SVeneziani/LogiVOX/Foto_Video/IMG_3594.jpeg

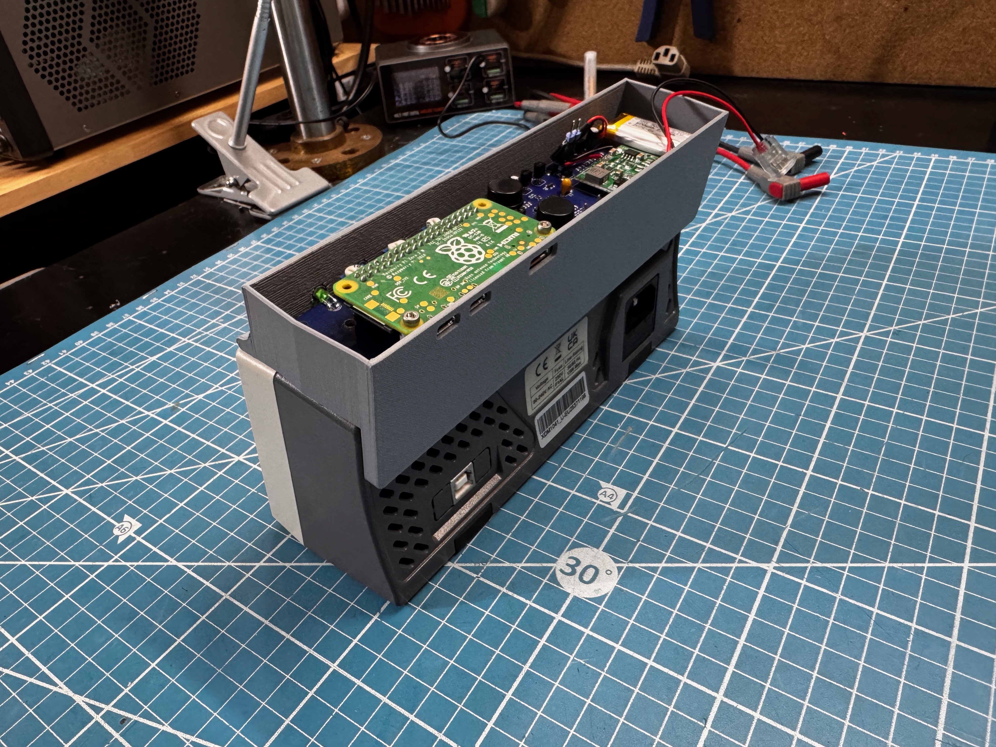
Foto_Video/IMG_3594.jpeg
