SVeneziani/LogiVOX/Foto_Video/IMG_3406.jpeg

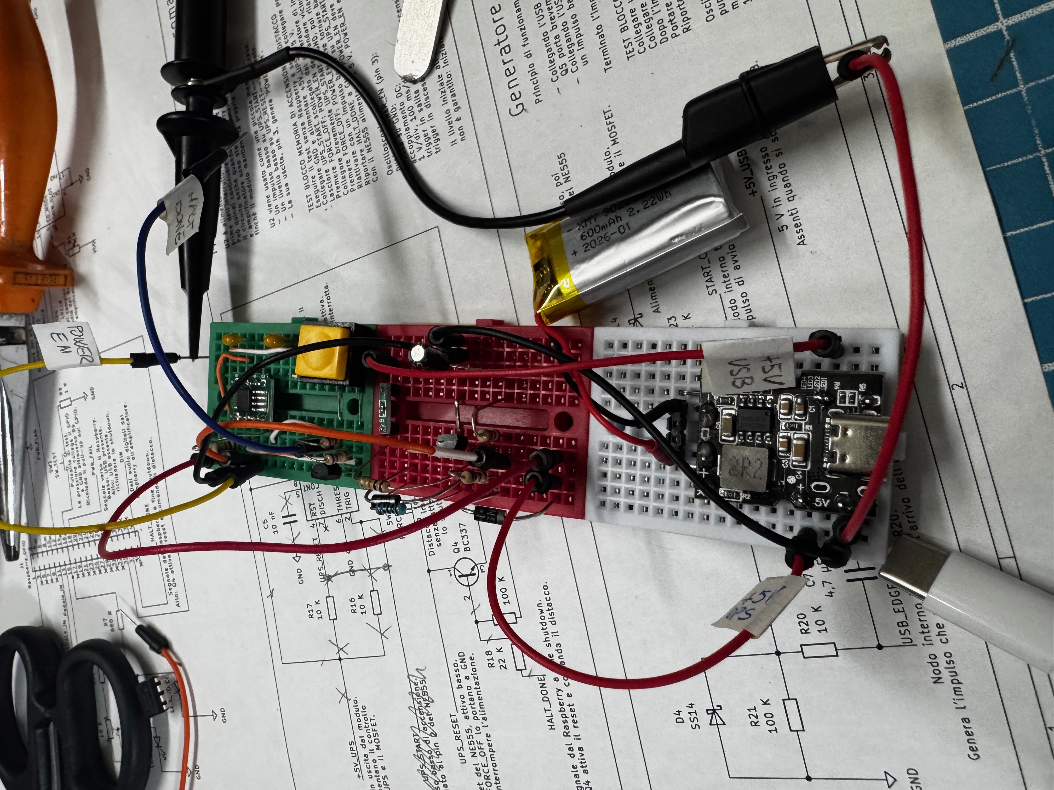
Foto_Video/IMG_3406.jpeg
