SVeneziani/LogiVOX/README.md

# LogiVOX

**Eyes on the probes. Ears on the measurement.**

[▶ Project video — 1 min 35 s, Full HD](Foto_Video/LogiVOX-presentation.mp4)

LogiVOX is a DIY speaking companion for the **OWON XDM1041**, built by Sergio Veneziani using a Raspberry Pi Zero 2 W, USB communication, a MAX98357A I²S amplifier, a foot pedal and a custom enclosure.

Keep your hands on the probes and let your multimeter speak. Tap a foot pedal for a reading, or enable AUTO to hear stable, meaningful changes. LogiVOX adds a voice to the bench through USB, without opening the multimeter.

[Documentazione italiana](README.it.md) · [Hardware review](docs/HARDWARE-REVIEW.md) · [TALK/AUTO](docs/TALK-AUTO.md)

## Project status

The assembled prototype works and has been tested by its builder. This repository is a **public development snapshot**, not yet a reproducible fabrication release. PCB DRC and schematic/PCB parity checks are clean; print instructions and neutral CAD exports are pending, as are audio redistribution and software licensing.

## Features

- Press the foot pedal or briefly press TALK to hear a reading.
- Hold TALK for two seconds to toggle AUTO, with spoken confirmation.
- AUTO speaks stable, significant changes instead of repeating every few seconds.
- Italian prerecorded number/unit fragments: normal operation does not require a cloud TTS service.
- READY and VOICE indicators.
- Battery-backed orderly shutdown, followed by hardware power disconnection.
- An existing OWON server supplies the USB connection, web dashboard and measurement API.

Only the OWON XDM1041 has been tested with this build. AUTO defaults to off at startup. FORCE OFF cuts power directly; it is not an orderly software shutdown.

## Parts used in the prototype

See the [component links](docs/COMPONENTS.md) for the foot pedal, power module and panel connectors used by the builder.

## Repository layout

- `Software/raspberry/bin/`: voice playback, pedal/TALK/AUTO and UPS services.
- `Software/raspberry/tests/`: hardware-independent logic tests.
- `Software/raspberry/services/`: existing service templates (paths currently reference the prototype user).
- `Software/tools/`: local voice generation helper for macOS.
- `hardware/kicad/`: current schematic/PCB/project snapshot.
- `docs/`: current pinout, operating notes and outstanding hardware review.
- `3D/`: Autodesk Fusion design and Bambu Studio project.
- `enclosure/`: enclosure file inventory and remaining print documentation.
- [Foto_Video/](Foto_Video/): 16 original photographs, the project presentation and a demonstration video.

## Tests

```sh
python3 -m unittest discover -s Software/raspberry/tests -v
```

The optional audio-file presence test is skipped when the voice pack is absent. This does not validate audio playback or the physical UPS.

## Installation status

See [installation notes](docs/INSTALLATION.md). The prototype runs Debian 13 on a Raspberry Pi Zero 2 W. A clean-device installation guide and complete service packaging are still being prepared; do not treat the current files as a one-click installer.

## Credits

- Design, assembly, mechanical enclosure and bench testing: **Sergio Veneziani**.
- Development and troubleshooting assistance: OpenAI ChatGPT/Codex; additional debugging with Cursor.
- USB/web/API backend: [Jason Antman's owon-xdm1041-server](https://github.com/jantman/owon-xdm1041-server), licensed MIT by its author. The backend is a separate dependency and is not vendored here.
- SCPI research credited by that backend: [TheHWcave/OWON-XDM1041](https://github.com/TheHWcave/OWON-XDM1041).
- Initial inspiration: [Arduino-Based Speech Add-on for Modern Multimeters with SCPI Protocol](https://www.pcbway.com/project/shareproject/Arduino_Based_Speech_Add_on_for_Modern_Multimeters_with_SCPI_Protocol_95abefd4.html). The original Arduino sketch is not included in this repository.

## Licensing

Original hardware and enclosure design contributions are offered under **CC BY-NC-SA 4.0**: attribution, noncommercial use and ShareAlike for shared adaptations. Commercial permission and any royalties require a separate written agreement with Sergio Veneziani.

See [licensing scope and exceptions](LICENSE.md). Software, general documentation, photographs/video, third-party materials and voice recordings are not covered by this design-file license. Earlier valid license grants are not revoked.
