SVeneziani/LogiVOX/docs/HARDWARE-REVIEW.md

# Hardware review before fabrication

Updated 2026-11-04 from the saved builder files. Design files were copied unchanged. The prototype was manually reworked; this snapshot is not yet a fabrication release. No old Gerbers are included.

## Verified PCB check

KiCad CLI DRC with schematic parity enabled reports:

- **0 DRC violations**.
- **0 unconnected items**.
- **0 schematic/PCB parity issues**.

Previous findings are no longer reported under the saved project rules. This verifies design-rule compliance and schematic/PCB consistency, not independent circuit operation or compatibility with a manufacturer's process. Check fabrication limits and generate fresh manufacturing outputs before ordering.
