SVeneziani/LogiVOX/Foto_Video/README.md

# LogiVOX — Foto e video

Materiali forniti da Sergio Veneziani: costruzione e prototipo. Le fotografie e il filmato IMG_3606.mov sono conservati senza modifiche.

## Presentazione

[▶ LogiVOX — video di presentazione](LogiVOX-presentation.mp4)

Durata circa 95 secondi, 1920×1080. Copia MP4 H.264/AAC compressa per la pubblicazione, derivata dal montaggio fornito dall’autore l’8 novembre 2026. Il montaggio non è stato modificato; l’originale resta conservato localmente.

## Foto e prima dimostrazione

- [IMG_3399.jpeg](IMG_3399.jpeg)
- [IMG_3405.jpeg](IMG_3405.jpeg)
- [IMG_3406.jpeg](IMG_3406.jpeg)
- [IMG_3407.jpeg](IMG_3407.jpeg)
- [IMG_3574.jpeg](IMG_3574.jpeg)
- [IMG_3575.jpeg](IMG_3575.jpeg)
- [IMG_3576.jpeg](IMG_3576.jpeg)
- [IMG_3578.jpeg](IMG_3578.jpeg)
- [IMG_3579.jpeg](IMG_3579.jpeg)
- [IMG_3580.jpeg](IMG_3580.jpeg)
- [IMG_3581.jpeg](IMG_3581.jpeg)
- [IMG_3582.jpeg](IMG_3582.jpeg)
- [IMG_3593.jpeg](IMG_3593.jpeg)
- [IMG_3594.jpeg](IMG_3594.jpeg)
- [IMG_3605.jpeg](IMG_3605.jpeg)
- [IMG_3606.mov](IMG_3606.mov)
- [IMG_3607.jpeg](IMG_3607.jpeg)
