SVeneziani/LogiVOX/Foto_Video/IMG_3399.jpeg

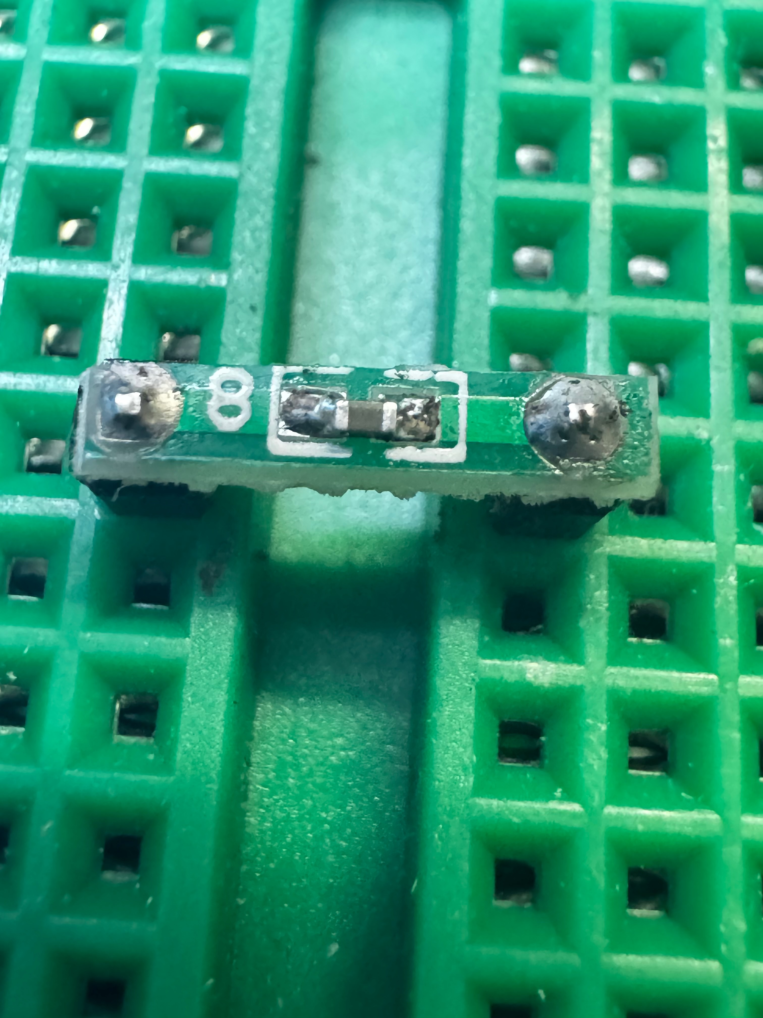
Foto_Video/IMG_3399.jpeg
