SVeneziani/LogiVOX/Foto_Video/IMG_3405.jpeg

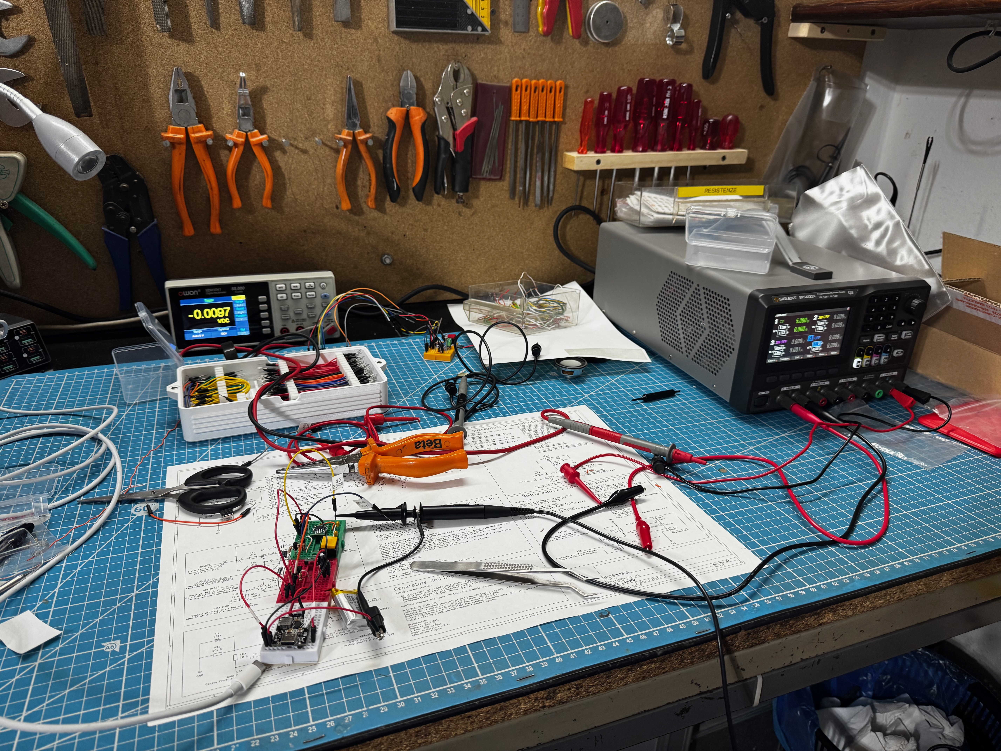
Foto_Video/IMG_3405.jpeg
