SVeneziani/LogiVOX/Foto_Video/IMG_3407.jpeg

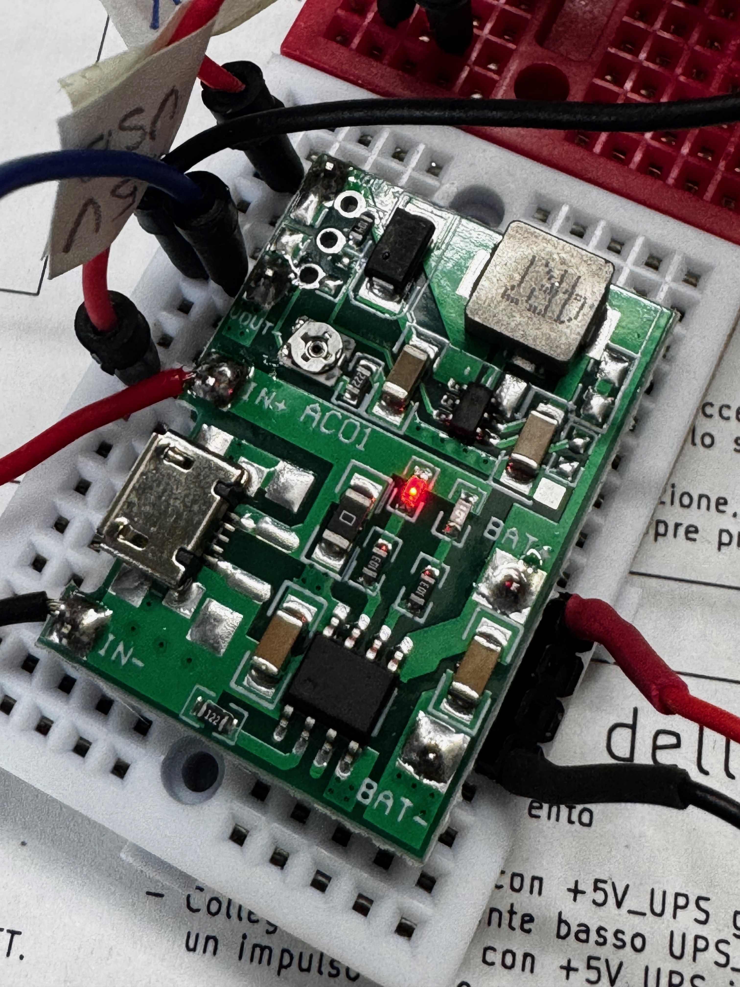
Foto_Video/IMG_3407.jpeg
