SVeneziani/LogiVOX/Foto_Video/IMG_3574.jpeg

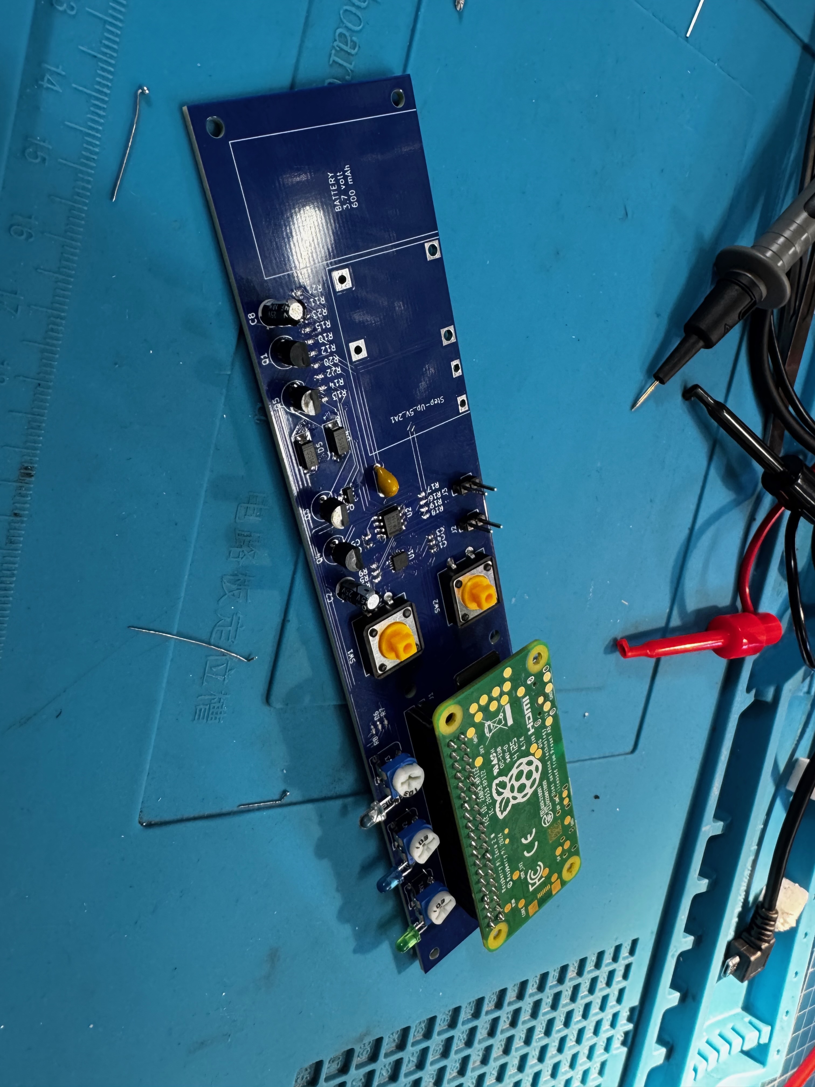
Foto_Video/IMG_3574.jpeg
