SVeneziani/LogiVOX/Foto_Video/IMG_3575.jpeg

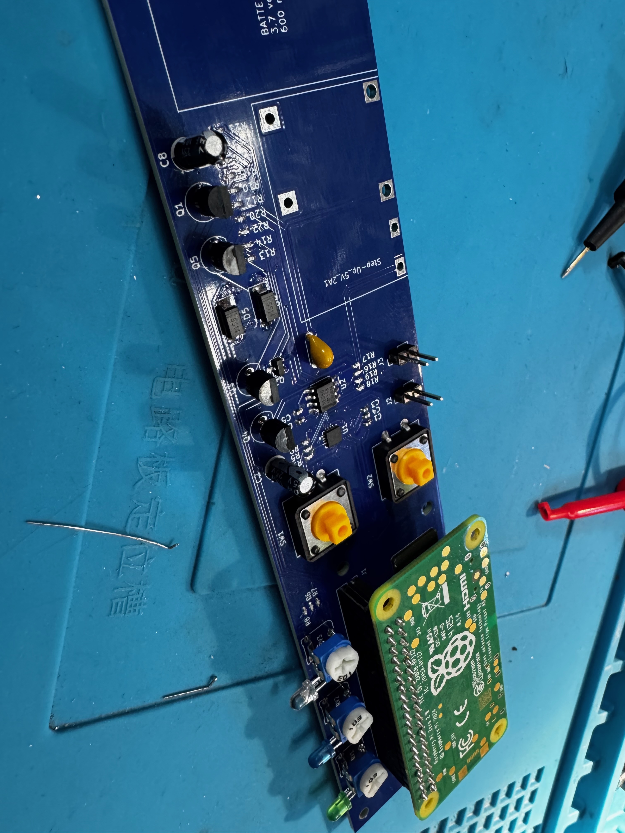
Foto_Video/IMG_3575.jpeg
