SVeneziani/LogiVOX/Foto_Video/IMG_3576.jpeg

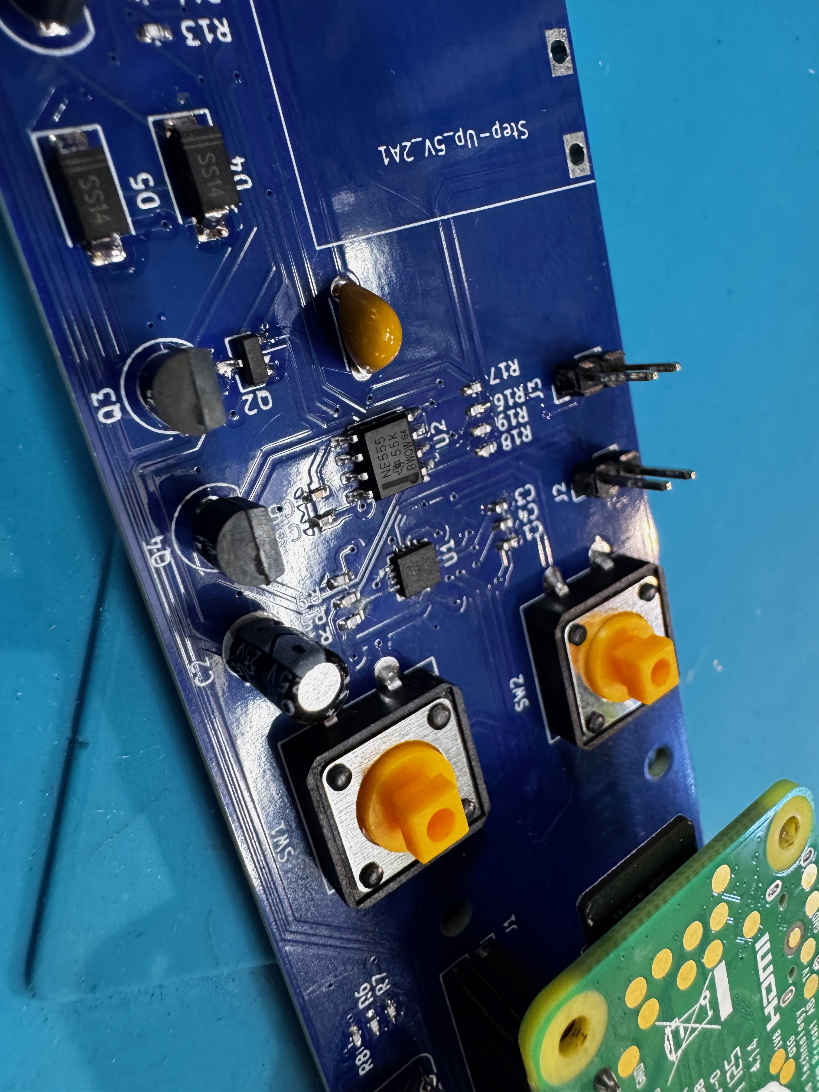
Foto_Video/IMG_3576.jpeg
