SVeneziani/LogiVOX/Foto_Video/IMG_3578.jpeg

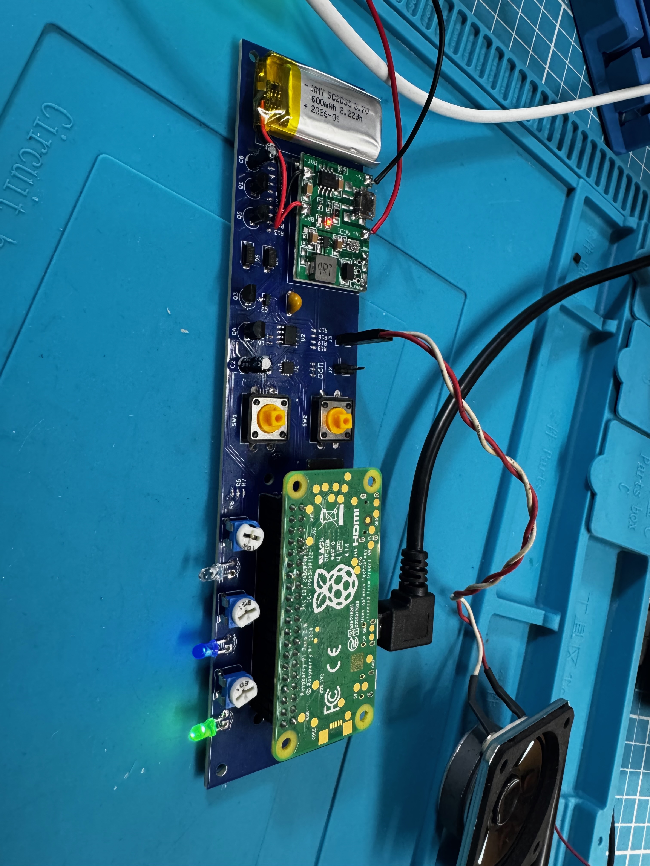
Foto_Video/IMG_3578.jpeg
