SVeneziani/LogiVOX/Foto_Video/IMG_3579.jpeg

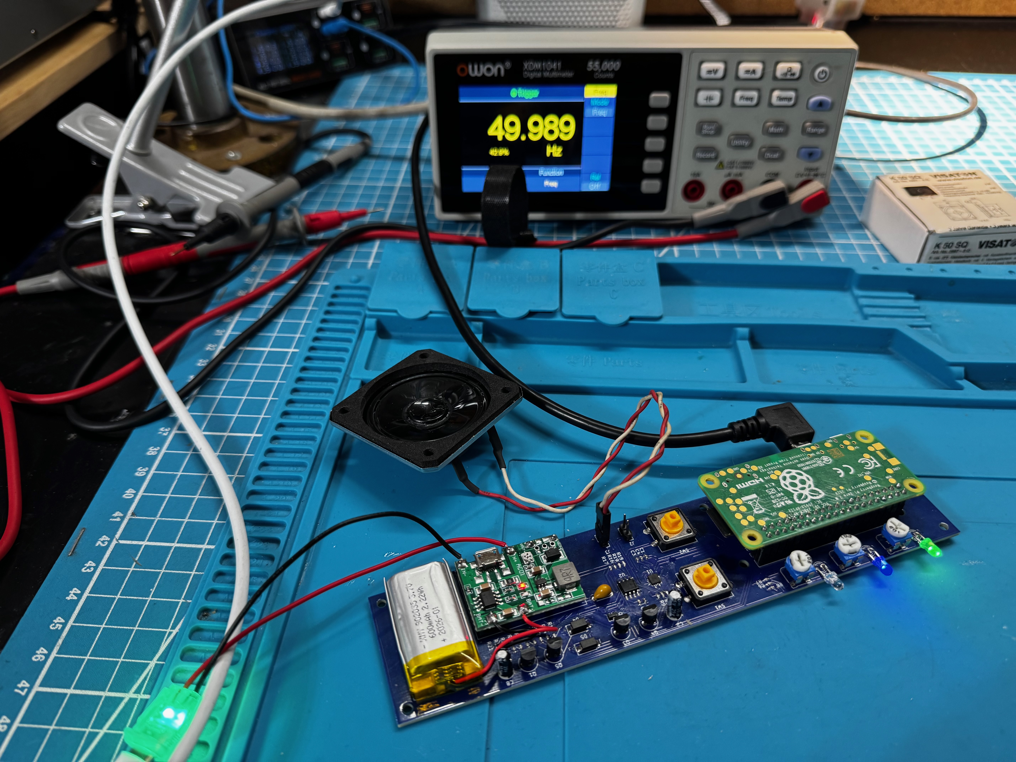
Foto_Video/IMG_3579.jpeg
