SVeneziani/LogiVOX/Foto_Video/IMG_3580.jpeg

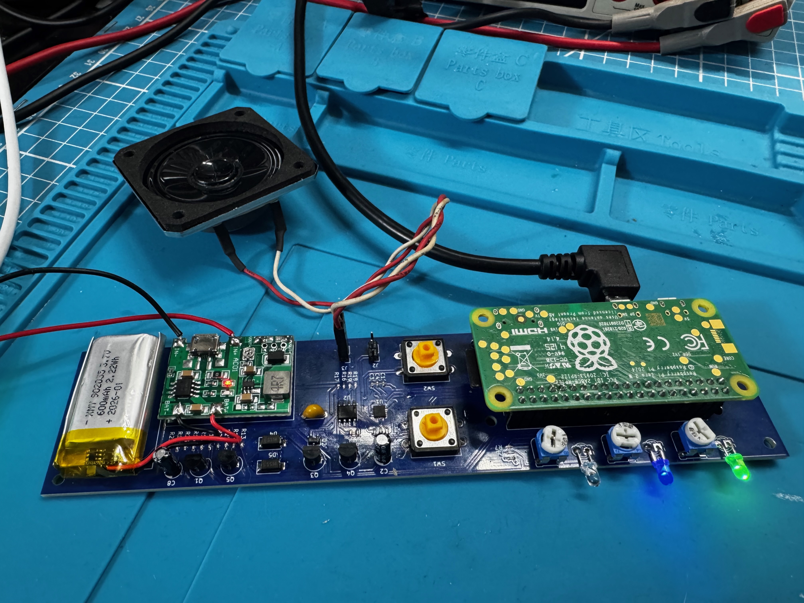
Foto_Video/IMG_3580.jpeg
