SVeneziani/LogiVOX/Foto_Video/IMG_3581.jpeg

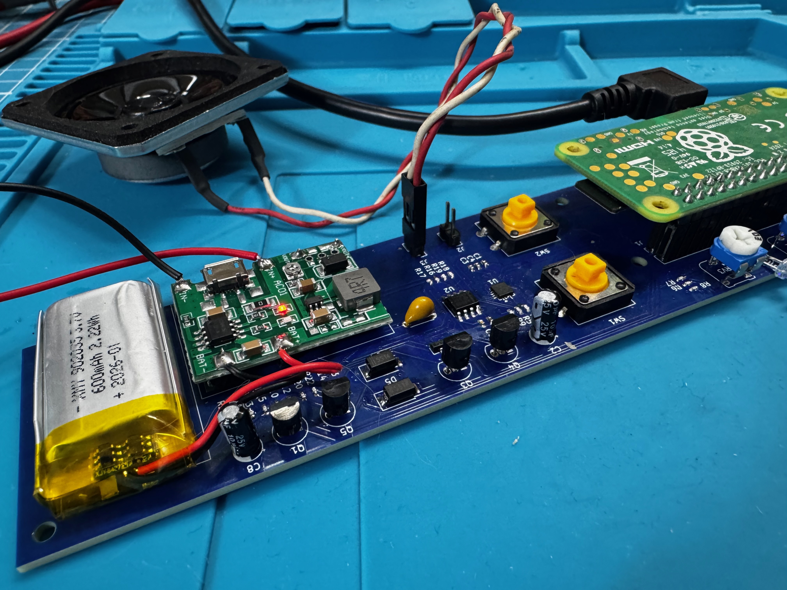
Foto_Video/IMG_3581.jpeg
