SVeneziani/LogiVOX/Foto_Video/IMG_3582.jpeg

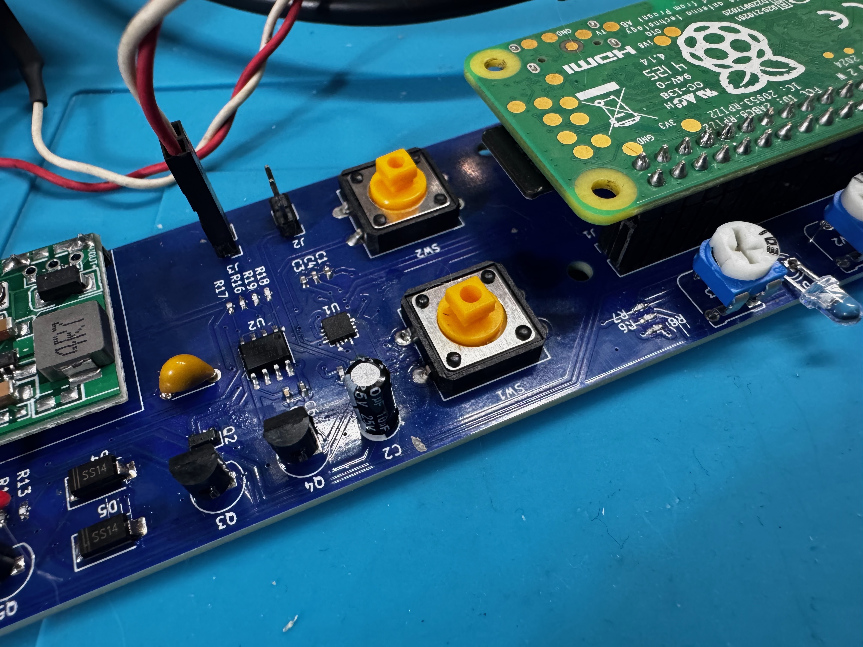
Foto_Video/IMG_3582.jpeg
