SVeneziani/LogiVOX/Foto_Video/IMG_3593.jpeg

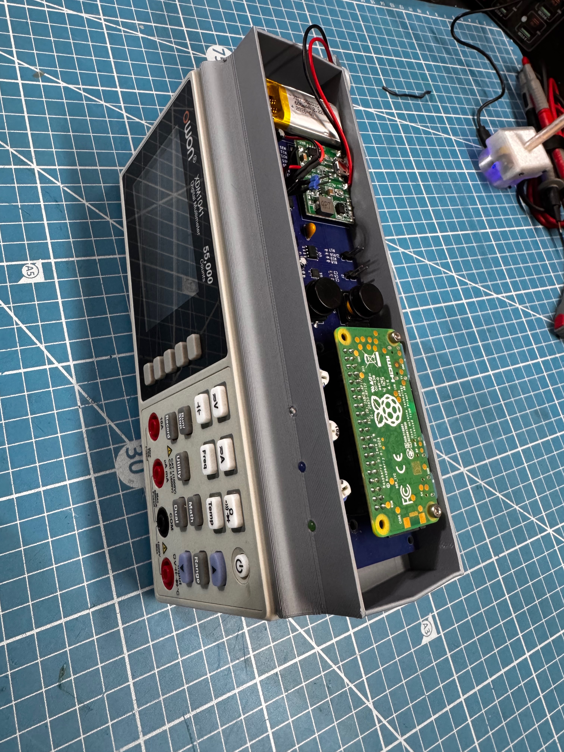
Foto_Video/IMG_3593.jpeg
