SVeneziani/LogiVOX/Foto_Video/IMG_3605.jpeg

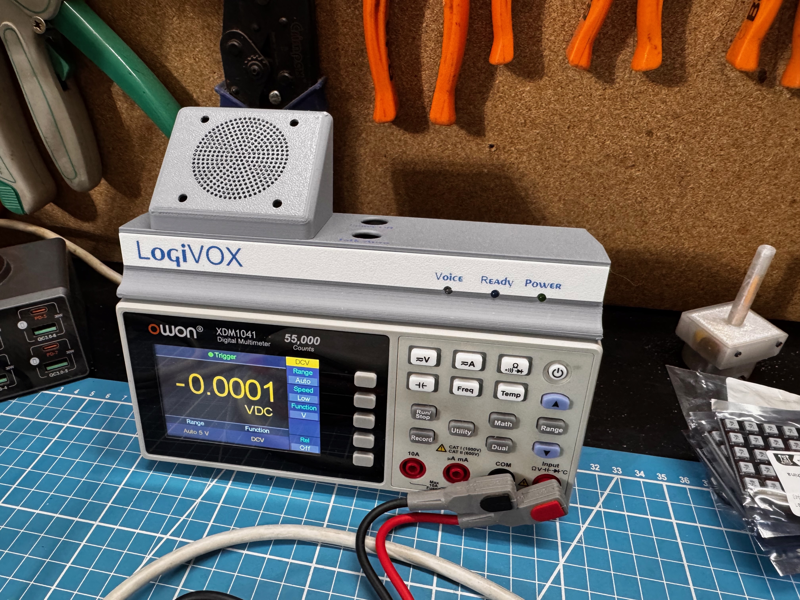
Foto_Video/IMG_3605.jpeg
