SVeneziani/LogiVOX/Foto_Video/IMG_3607.jpeg

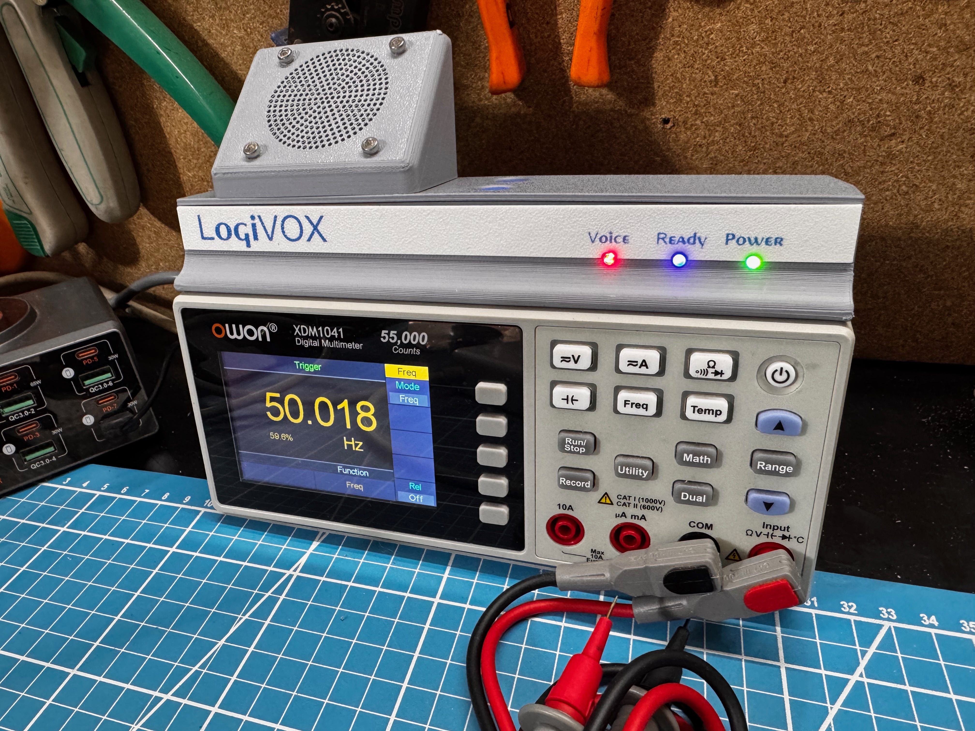
Foto_Video/IMG_3607.jpeg
