SVeneziani/LogiVOX/docs/COMPONENTS.md

# Componenti acquistati / Purchased components

Link forniti da Sergio Veneziani per i componenti utilizzati nel prototipo LogiVOX. I parametri di tracciamento sono stati rimossi dagli indirizzi.

| Componente / Component | Link |
| --- | --- |
| Pedale / Foot pedal | [Amazon — B07PPPZZXS](https://www.amazon.it/dp/B07PPPZZXS) |
| Schedina di alimentazione / Power module | [Amazon — B0DPLG45NC](https://www.amazon.it/dp/B0DPLG45NC) |
| Connettore del pedale / Foot pedal connector | [Amazon — B01LZT2PW8](https://www.amazon.it/dp/B01LZT2PW8) |
| Connettore USB-C a pannello / Panel-mount USB-C connector | [AliExpress — 1005009289182853](https://it.aliexpress.com/item/1005009289182853.html) |

Questa è una lista dei componenti acquistati, non la distinta completa del progetto. Le pagine commerciali possono cambiare: confrontare variante, dimensioni e collegamenti con il progetto prima di acquistare. Le specifiche delle inserzioni non sono state verificate indipendentemente.

These are builder-supplied purchase references, not a complete bill of materials. Check the selected variant, dimensions and wiring against the project; listing specifications have not been independently verified.
