SVeneziani/LogiVOX/3D/BambuStudio/LogiVOX.3mf

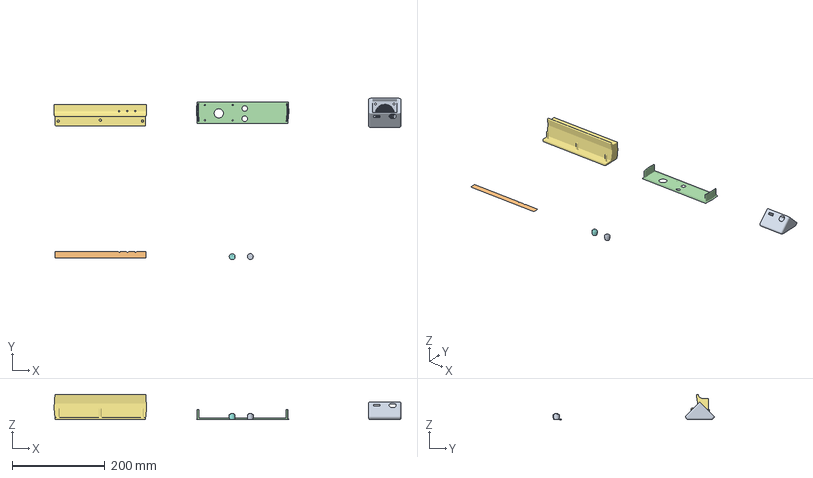
[picture p17: CAD file, 2026-11-04]
3D/BambuStudio/LogiVOX.3mf
749.0 x 348.6 x 55.0 mm
Corpo19
LogiVOX-Front
Cover (1)
Cover
ForceOff-1
ForceOff-2
ForceOff-3
ForceOff-4
ForceOff-5
ForceOff-6
ForceOff-7
ForceOff-8
TalkAuto-1
TalkAuto-10
TalkAuto-2
TalkAuto-3
TalkAuto-4
TalkAuto-5
TalkAuto-6
TalkAuto-7
TalkAuto-8
TalkAuto-9
Main
Button x 2
