SVeneziani/LogiVOX/(list of files, cad)

Other CAD files:
3D/AutodeskFusion/LogiVOX.f3d
