SVeneziani/LogiVOX/hardware/kicad/LogiVox.kicad_pcb

## KiCad design hardware/kicad/LogiVox.kicad_pcb (2026-11-04)

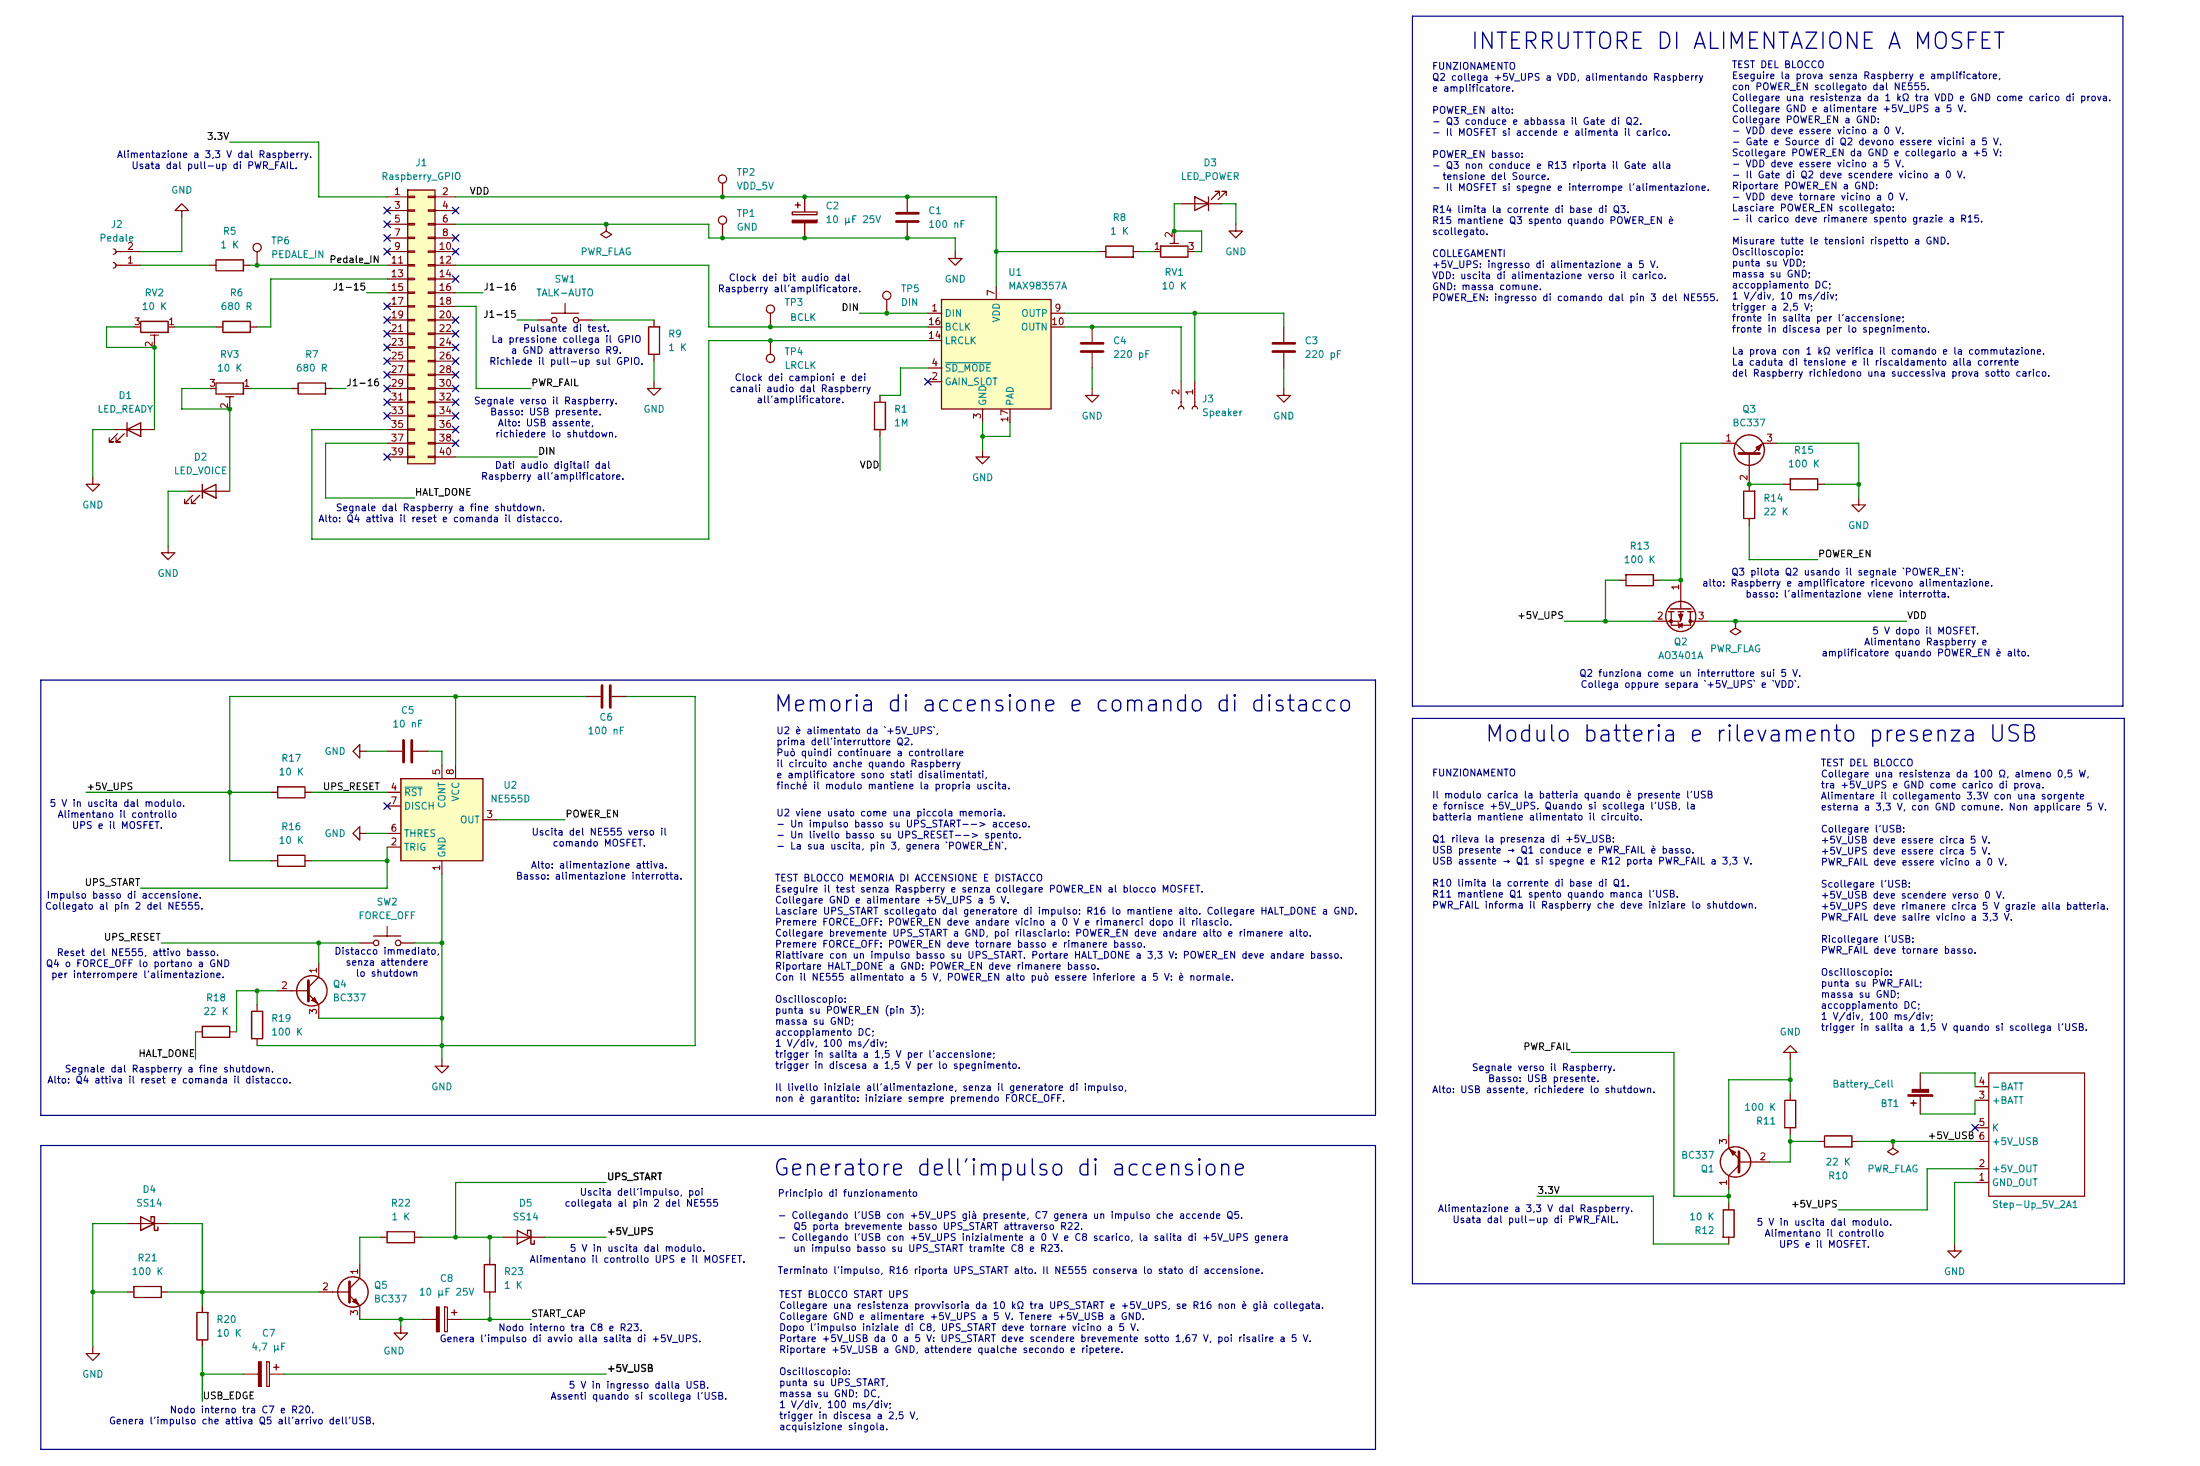
[picture p18: schematic LogiVox.kicad_sch]

Parts:
BT1: Battery_Cell
C1, C6: 100 nF; C_0402_1005Metric_Pad0.74x0.62mm_HandSolder
C2, C8: 10 µF 25V; CP_Radial_D4.0mm_P1.50mm
C3, C4: 220 pF; C_0402_1005Metric_Pad0.74x0.62mm_HandSolder
C5: 10 nF; C_0402_1005Metric_Pad0.74x0.62mm_HandSolder
C7: 4,7 µF; CP_Radial_D4.0mm_P1.50mm
D1: LED_READY; LED_D3.0mm
D2: LED_VOICE; LED_D3.0mm
D3: LED_POWER; LED_D3.0mm
D4, D5: SS14; D_SMA
J1: Raspberry_GPIO; PinSocket_2x20_P2.54mm_Vertical
J2: Pedale; PinHeader_1x02_P2.54mm_Vertical
J3: Speaker; PinHeader_1x02_P2.54mm_Vertical
Q1, Q3, Q4, Q5: BC337; TO-92_Inline
Q2: AO3401A; SOT-23
R1: 1M; R_0402_1005Metric_Pad0.72x0.64mm_HandSolder
R5, R8, R9, R22, R23: 1 K; R_0402_1005Metric_Pad0.72x0.64mm_HandSolder
R6, R7: 680 R; R_0402_1005Metric_Pad0.72x0.64mm_HandSolder
R10, R14, R18: 22 K; R_0402_1005Metric_Pad0.72x0.64mm_HandSolder
R11, R13, R15, R19, R21: 100 K; R_0402_1005Metric_Pad0.72x0.64mm_HandSolder
R12, R16, R17, R20: 10 K; R_0402_1005Metric_Pad0.72x0.64mm_HandSolder
RV1, RV2, RV3: 10 K; Potentiometer_Runtron_RM-065_Vertical
SW1: TALK-AUTO; SW_PUSH-12mm
SW2: FORCE_OFF; SW_PUSH-12mm
Step-Up_5V_2A1: Step-Up Regolabile
TP1: GND; TestPoint_Pad_1.5x1.5mm
TP2: VDD_5V; TestPoint_Pad_1.5x1.5mm
TP3: BCLK; TestPoint_Pad_1.5x1.5mm
TP4: LRCLK; TestPoint_Pad_1.5x1.5mm
TP5: DIN; TestPoint_Pad_1.5x1.5mm
TP6: PEDALE_IN; TestPoint_Pad_1.5x1.5mm
U1: MAX98357A; TQFN-16-1EP_3x3mm_P0.5mm_EP1.23x1.23mm_ThermalVias
U2: NE555D; SOIC-8_3.9x4.9mm_P1.27mm

Connections:
/3.3V: J1.1, R12.2
/+5V_UPS: C6.2, D5.1 (K), Q2.2 (S), R13.2, R16.2, R17.2, Step-Up_5V_2A1.2 (+5V_OUT), U2.8 (VCC)
/+5V_USB: C7.1, R10.2, Step-Up_5V_2A1.6 (+5V_USB)
/DIN: J1.40, TP5.1 (1_1), U1.1 (DIN)
/HALT_DONE: J1.37, R18.2
/J1-15: J1.15, SW1.1
/J1-16: J1.16, R7.2
/POWER_EN: R14.1, U2.3 (OUT)
/PWR_FAIL: J1.18, Q1.1 (C), R12.1
/Pedale_IN: J1.11, R5.2, TP6.1 (1_1)
/START_CAP: C8.1, R23.1
/UPS_RESET: Q4.1 (C), R17.1, SW2.1, U2.4 (~RST)
/UPS_START: D5.2 (A), R16.1, R22.1, R23.2, U2.2 (TRIG)
/USB_EDGE: C7.2, R20.1
/VDD: C1.1, C2.1, J1.2, Q2.3 (D), R1.2, R8.1, TP2.1 (1_1), U1.7 (VDD), U1.8 (VDD)
GND: C1.2, C2.2, C3.2, C4.2, C5.2, C6.1, C8.2, D1.1 (K), D2.1 (K), D3.1 (K), D4.2 (A), J1.6, J2.2, Q1.3 (E), Q3.3 (E), Q4.3 (E), Q5.3 (E), R9.1, R11.1, R15.1, R19.1, R21.2, SW2.2, Step-Up_5V_2A1.1 (GND_OUT), TP1.1 (1_1), U1.3 (GND), U1.11 (GND), U1.15 (GND), U1.17 (PAD), U2.1 (GND), U2.6 (THRES)
unnamed: D1.2 (A), RV2.2, RV2.3
unnamed: D2.2 (A), RV3.2, RV3.3
unnamed: D3.2 (A), RV1.2, RV1.3
unnamed: D4.1 (K), Q5.2 (B), R20.2, R21.1
unnamed: J1.12, TP3.1 (1_1), U1.16 (BCLK)
unnamed: J1.13, R6.2
unnamed: J1.35, TP4.1 (1_1), U1.14 (LRCLK)
unnamed: J2.1, R5.1
unnamed: C3.1, J3.1, U1.9 (OUTP)
unnamed: C4.1, J3.2, U1.10 (OUTN)
unnamed: Q1.2 (B), R10.1, R11.2
unnamed: Q2.1 (G), Q3.1 (C), R13.1
unnamed: Q3.2 (B), R14.2, R15.2
unnamed: Q4.2 (B), R18.1, R19.2
unnamed: Q5.1 (C), R22.2
unnamed: R6.1, RV2.1
unnamed: R7.1, RV3.1
unnamed: R8.2, RV1.1
unnamed: R9.2, SW1.2
unnamed: BT1.1 (+), Step-Up_5V_2A1.3 (+BATT)
unnamed: BT1.2 (-), Step-Up_5V_2A1.4 (-BATT)
unnamed: R1.1, U1.4 (~SD_MODE)
unnamed: C5.1, U2.5 (CONT)

Notes on the sheet:
Reset del NE555, attivo basso. Q4 o FORCE_OFF lo portano a GND per interrompere l’alimentazione.
Nodo interno tra C7 e R20. Genera l’impulso che attiva Q5 all’arrivo dell’USB.
Q2 funziona come un interruttore sui 5 V. Collega oppure separa `+5V_UPS` e `VDD`.
Impulso basso di accensione. Collegato al pin 2 del NE555.
Alimentazione a 3,3 V dal Raspberry. Usata dal pull-up di PWR_FAIL.
Uscita dell'impulso, poi collegata al pin 2 del NE555
5 V in uscita dal modulo. Alimentano il controllo UPS e il MOSFET.
INTERRUTTORE DI ALIMENTAZIONE A MOSFET
Distacco immediato, senza attendere lo shutdown
Uscita del NE555 verso il comando MOSFET. Alto: alimentazione attiva. Basso: alimentazione interrotta.
Generatore dell'impulso di accensione
Segnale dal Raspberry a fine shutdown. Alto: Q4 attiva il reset e comanda il distacco.
Modulo batteria e rilevamento presenza USB
TEST BLOCCO MEMORIA DI ACCENSIONE E DISTACCO Eseguire il test senza Raspberry e senza collegare POWER_EN al blocco MOSFET. Collegare GND e alimentare +5V_UPS a 5 V. Lasciare UPS_START scollegato dal generatore di impulso: R16 lo mantiene alto. Collegare HALT_DONE a GND. Premere FORCE_OFF: POWER_EN 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
5 V in uscita dal modulo. Alimentano il controllo UPS e il MOSFET.
Memoria di accensione e comando di distacco
Segnale verso il Raspberry. Basso: USB presente. Alto: USB assente, richiedere lo shutdown.
TEST DEL BLOCCO Collegare una resistenza da 100 Ω, almeno 0,5 W, tra +5V_UPS e GND come carico di prova. Alimentare il collegamento 3.3V con una sorgente esterna a 3,3 V, con GND comune. Non applicare 5 V. Collegare l’USB: +5V_USB deve essere circa 5 V. +5V_UPS deve essere circa 5 V. PWR_FAIL deve 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
FUNZIONAMENTO Il modulo carica la batteria quando è presente l’USB e fornisce +5V_UPS. Quando si scollega l’USB, la batteria mantiene alimentato il circuito. Q1 rileva la presenza di +5V_USB: USB presente → Q1 conduce e PWR_FAIL è basso. USB assente → Q1 si spegne e R12 porta PWR_FAIL a 3,3 V. R10 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
TEST BLOCCO START UPS Collegare una resistenza provvisoria da 10 kΩ tra UPS_START e +5V_UPS, se R16 non è già collegata. Collegare GND e alimentare +5V_UPS a 5 V. Tenere +5V_USB a GND. Dopo l'impulso iniziale di C8, UPS_START deve tornare vicino a 5 V. Portare +5V_USB da 0 a 5 V: UPS_START deve sce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
Clock dei campioni e dei canali audio dal Raspberry all’amplificatore.
Dati audio digitali dal Raspberry all’amplificatore.
Nodo interno tra C8 e R23. Genera l’impulso di avvio alla salita di +5V_UPS.
Pulsante di test. La pressione collega il GPIO a GND attraverso R9. Richiede il pull-up sul GPIO.
Principio di funzionamento - Collegando l'USB con +5V_UPS già presente, C7 genera un impulso che accende Q5. Q5 porta brevemente basso UPS_START attraverso R22. - Collegando l'USB con +5V_UPS inizialmente a 0 V e C8 scarico, la salita di +5V_UPS genera un impulso basso su UPS_START tramite C8 e R23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
TEST DEL BLOCCO Eseguire la prova senza Raspberry e amplificatore, con POWER_EN scollegato dal NE555. Collegare una resistenza da 1 kΩ tra VDD e GND come carico di prova. Collegare GND e alimentare +5V_UPS a 5 V. Collegare POWER_EN a GND: - VDD deve essere vicino a 0 V. - Gate e Source di Q2 devono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
Q3 pilota Q2 usando il segnale `POWER_EN`: alto: Raspberry e amplificatore ricevono alimentazione. basso: l'alimentazione viene interrotta.
U2 viene usato come una piccola memoria. - Un impulso basso su UPS_START--> acceso. - Un livello basso su UPS_RESET--> spento. - La sua uscita, pin 3, genera `POWER_EN`.
Clock dei bit audio dal Raspberry all’amplificatore.
5 V in ingresso dalla USB. Assenti quando si scollega l'USB.
Segnale verso il Raspberry. Basso: USB presente. Alto: USB assente, richiedere lo shutdown.
FUNZIONAMENTO Q2 collega +5V_UPS a VDD, alimentando Raspberry e amplificatore. POWER_EN alto: - Q3 conduce e abbassa il Gate di Q2. - Il MOSFET si accende e alimenta il carico. POWER_EN basso: - Q3 non conduce e R13 riporta il Gate alla tensione del Source. - Il MOSFET si spegne e interrompe l'alim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
5 V dopo il MOSFET. Alimentano Raspberry e amplificatore quando POWER_EN è alto.
U2 è alimentato da `+5V_UPS`, prima dell'interruttore Q2. Può quindi continuare a controllare il circuito anche quando Raspberry e amplificatore sono stati disalimentati, finché il modulo mantiene la propria uscita.

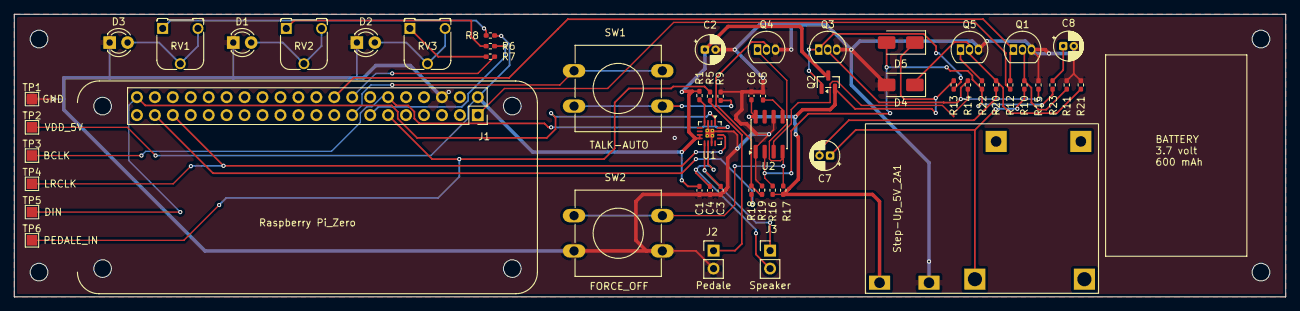
[picture p19: board LogiVox.kicad_pcb from above]

Board: 2 copper layers, 180.0 x 40.0 mm, 63 parts (0 on the bottom side), 37 nets.

Other parts of the board:
HE1, HE2, HE3, HE4: MountingHole_2.5mm
HI1, HI2, HI3, HI4: MountingHole_2.5mm
