SVeneziani/LogiVOX/(commit log)

2026-11-04 Prepare LogiVOX private project draft
    [LogiVox.kicad_pcb, LogiVox.kicad_sch]
2026-11-04 Add original Fusion and Bambu Studio enclosure files
    [Button.3mf, LogiVOX.f3d]
2026-11-04 Sync corrected PCB and document clean DRC with remaining parity warnings
    [LogiVox.kicad_pcb]
2026-11-04 Add project photos and video, sync PCB with fully clean DRC and parity
    [LogiVox.kicad_pcb, LogiVox.kicad_sch]
2026-11-04 Align design-file licensing with PCBWay CC BY-NC-SA 4.0
2026-11-05 Revise TALK/AUTO documentation for clarity and updates
    Updated the documentation for TALK/AUTO with details on pin configuration and service behavior.
2026-11-05 Rename Bambu project to LogiVOX and reconcile TALK AUTO documentation
    [LogiVOX.3mf]
